aplavins/Arduino-MPPT/IMG_0304.JPG

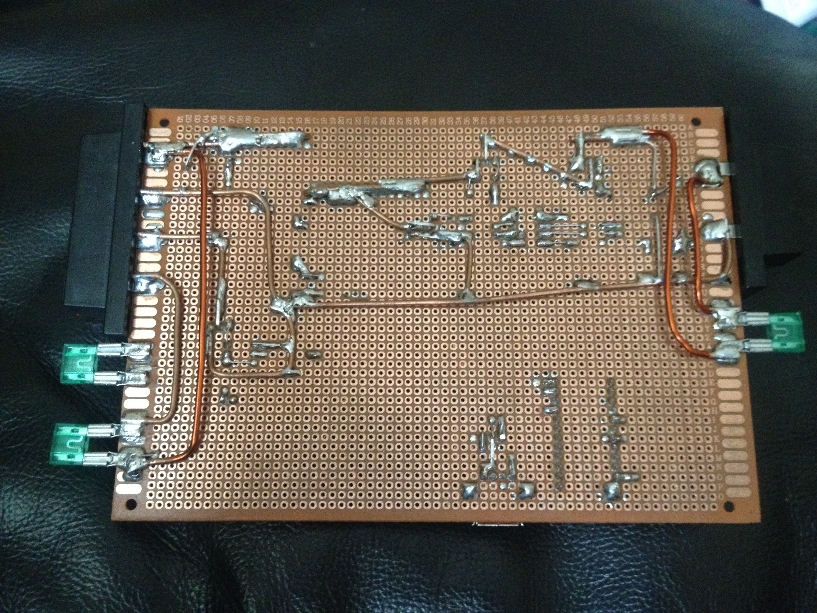
IMG_0304.JPG
