aplavins/Arduino-MPPT/IMG_0303.JPG

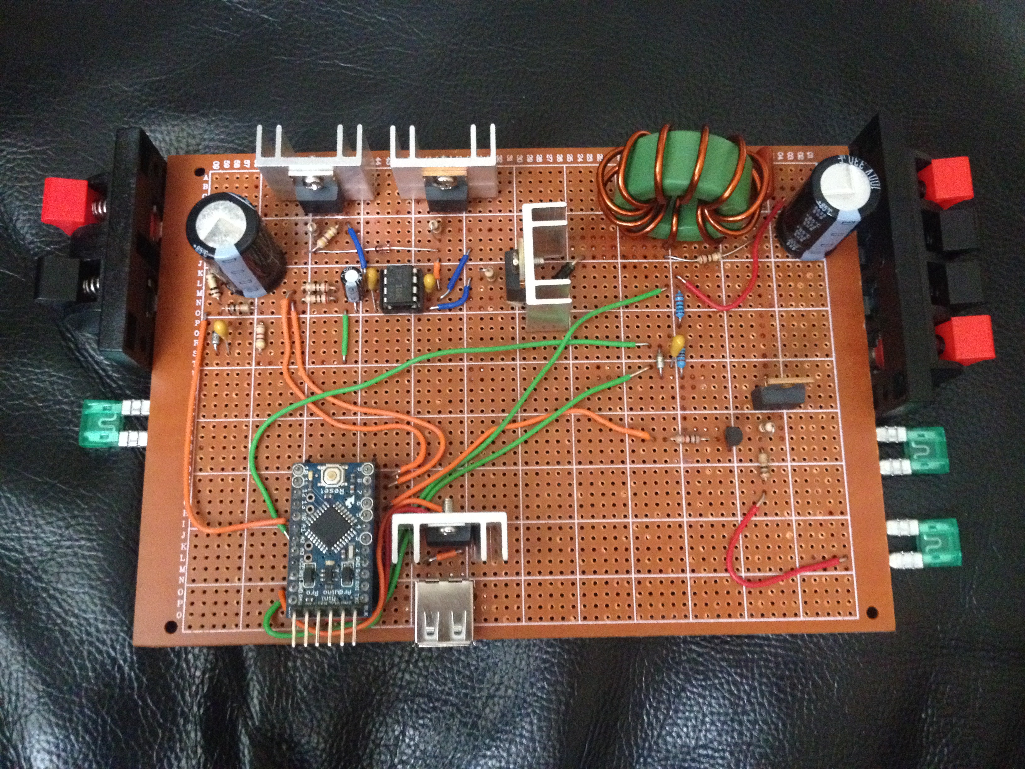
IMG_0303.JPG
