aplavins/Arduino-MPPT/fan pinout.JPG

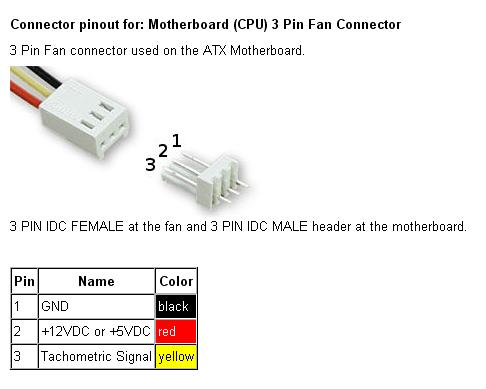
fan pinout.JPG
