aplavins/Arduino-MPPT/MPPT charge controller barebones.pdf

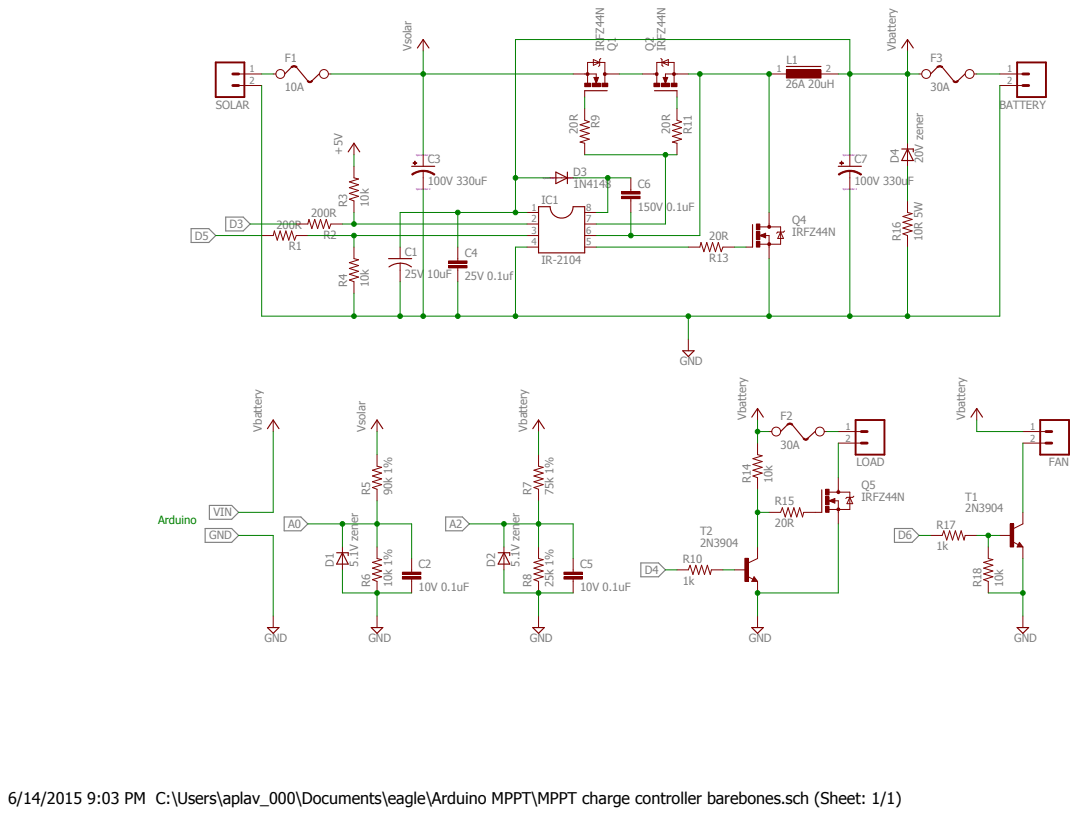
[picture p4: page 1]

6/14/2015 9:03 PM C:\Users\aplav_000\Documents\eagle\Arduino MPPT\MPPT charge controller barebones.sch (Sheet: 1/1)
