aplavins/Arduino-MPPT/(threads)

Thread 1 (2015-06-12):

Inductor

juan3211, 2015-06-12:
Hi,

Thanks a lot !!!! Waht about and schema or similar ? I have check other MPPT in instructables and tim lonan, but yours is for 250W, I have a doubt, what inductor do you use?

Best regards

aplavins, 2015-06-14:
I wound my own 20uH ferrite core inductor with 14awg magnet wire. Schematic
is coming soon!

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

--
When there's a smile in your heart
There's no better time to start
Think of all the joy you'll find
When you leave the world behind
And bid your cares good-bye

aplavins, 2015-06-15:
schematic is up
https://github.com/aplavins/Arduino-MPPT/blob/master/MPPT%20charge%20controller%20barebones.pdf

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

--
When there's a smile in your heart
There's no better time to start
Think of all the joy you'll find
When you leave the world behind
And bid your cares good-bye

aplavins, 2015-06-15:
Here are some links that will allow you to build your own inductor

http://www.ebay.com/itm/22mm-x-14mm-x-8mm-Round-Green-Toroid-Ferrite-Cores-10-Pcs-/271566883360

http://www.ebay.com/itm/Magnet-Wire-14-AWG-Gauge-Enameled-Copper-4oz-155C-20ft-Magnetic-Coil-Winding-/261085726306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

You can also salvage these components from used power electronics

use this calculator to find out what value inductor you need:
http://www.daycounter.com/Calculators/Switching-Converter-Calculator.phtml

and this one to find the number of turns for the core and wire you have:
http://coil32.net/online-calculators/ferrite-torroid-calculator.html

Hope this helps!

Closed 2015-06-15.

Thread 2 (2020-03-02):

Output voltage

parthasarathi1619, 2020-03-02:
How to get 24 volt output

aplavins, 2020-03-19:
This circuit is designed to charge a 12V lead acid battery. Changing the output to 24V would require an entire rework of the circuit.

parthasarathi1619, 2020-03-23:
Ok thank-you

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

Thread 3 (2020-03-19):

Low side mosfet burns when the battery is connected

Daniel-Blankenship, 2020-03-19:
Hello,

I attempted to build this project but the low side mosfet gets fried immediately when I connect the battery. I took note of your warning that setting the pulseWidth to a low value will short it out. The main thing I did different with mine was that I powered my Arduino with a usb power bank for testing purposes. I was afraid of connecting vin to the charging battery in case of a voltage spike. I connected the usb power to the arduino first, and then when I connected the charging battery, the low side mosfet popped like a firecracker. The arduino was fine though, and none of the other mosfets seemed damaged according to some testing with a multi-meter.

I have a few assumptions, and please do correct me if I'm wrong, I'm still somewhat inexperienced with these type of electrical projects.

Given that the mosfet burns if the pulse width is set too low, I assume if the IR2104 isn't working then it would also cause this to happen. As far as I understand, it has to be always running or else the low side mosfet makes a closed circuit through the inductor and battery which causes it to fry. I could be wrong though. This makes me think of another potential issue, if the arduino is powered from the 12v battery, would the mosfet cook before the arduino could start up its pwm output to the mosfet driver?

Would adding a diode between the low side mosfets drain and the inductor prevent this burning? Maybe I don't know something that would make adding a diode there a bad idea.

I suspect that my circuit board wiring could have been wrong or maybe a faulty IR2104 that wasn't driving the low side mosfet. I did not have any panels or loads connected when I tested this, I only got to attaching the 12v battery before I had trouble. I replaced the fried mosfet with a new one, thinking that the fried one might have been bad, but the replacement fried too. I'm going to give this another try with a fresh set of components and organize my layout of them better in case I made any mistakes following the schematic.

Thanks for all the work you put into this project, if you have any suggestions please let me know.

aplavins, 2020-03-19:
You need to power the arduino from the battery that you are charging. That's how it gets it's reference voltages, and sets the PWM. It's also possible the IR2104 is faulty.

Daniel-Blankenship, 2020-03-21:
I discovered that I made a dumb mistake haha. The IR2104 chips I have, had a circular indention on the underside in one of the bottom corners that I mistook for being the pin 1 indicator. The actual indicator was printed on the top, on the opposite corner, so I had the chip connected backwards which likely contributed to my mosfet going up in smoke.

Also this time I powered my arduino off the battery as you explained. Even though 12v is recommended, I learned that they could potentially handle up to 20v if the voltage regulator isn't being drawn from too heavily. I was concerned that the lead acid battery when charged could possibly reach 14-15 volts at its highest but it seems that this isn't a problem.

I put together a stripped down version of this circuit on a breadboard for testing ir2104's, it just uses an led for the load instead of running an inductor coil. I made some test code and everything worked perfectly. The led changes brightness accordingly as I modify the pwm values through 75-245, making sure to disable the driver during changes.

I also educated myself a bit more about ir2104 half bridges, it seems its fine not immediately having pwm from the arduino when power is first received, which makes more sense than what I speculated about it starting up the pwm my first post. I later tested this by powering it without the arduino connected and nothing melted.

I appreciate you pointing me in the right direction, thank you for your help!

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

svdrummer, 2020-03-22:
Thank you for following up with this. Good feedback for us all.

On Sat, 21 Mar 2020, 10:53 am Daniel Blankenship, <notifications@github.com>
wrote:

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

Closed 2020-04-03.

Thread 4 (2020-05-28):

License Question

heuj, 2020-05-28:
Dear Adam,
thanks for publishing this great project! I am currently building my own device based on your design and am currently working on the PCB layout. Thinking about pushing it to github as well, however I am not sure which license to apply. In your schematic and source file I only found "This is an open source project and you are free to use any code you like. Please give credit.", the github project however says GPL. Not sure about the license of the timnolan project you cited.

I would be glad to know if I am free to choose another license (e.g. MIT) or have to stick to GPL.
Thank you very much!

aplavins, 2020-05-28:
Hi Heuj,

On github I chose the license that was the least restrictive. I want
everyone to learn and improve on the code and circuit design. All I ask is
that you put my name and all of my contributors names in comments in the
code. Happy making.

Adam.

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

Thread 5 (2021-08-10):

Functionnal error in PWM adjustment

pierre83, 2021-08-10:
It seems to be an error in the process (lines 249 - 263)
When stepAmount is < 1 then it value is 1, but when (Vcvm - panelVolts) /10 is -50 (for example) then the step is forced to 1, then the PWM is not correctly adjusted because a too little step.

aplavins, 2021-09-09:
The step amount has to be an integer number and I don't want it to be zero, which is why it has to be at least 1. The pwm will fluctuate up and down around the ideal point. Line 249 is so that when the target pwn is far away from the current pwm, it takes steps that are larger than 1 to get there in fewer cycles.

Closed 2021-09-09.
