aplavins/Arduino-MPPT/(commit log)

2015-06-11 Added arduino code
2015-06-15 V0.2
    - Added fan control
    - changed to interger addition instead of floats
    - fixed blinks, now without delay
    [Arduino-MPPT.ino]
2015-06-15 fixed fan
    fixed an issue that was causing the fan not to work.
    [Arduino-MPPT.ino]
2015-06-17 fixed sleep
    improved sleep state recognition
    [Arduino-MPPT.ino]
